jsarrett/StackedCharger/6s_750mA/6s_750mA.kicad_pcb

## KiCad design 6s_750mA/6s_750mA.kicad_pcb (2024-08-13)

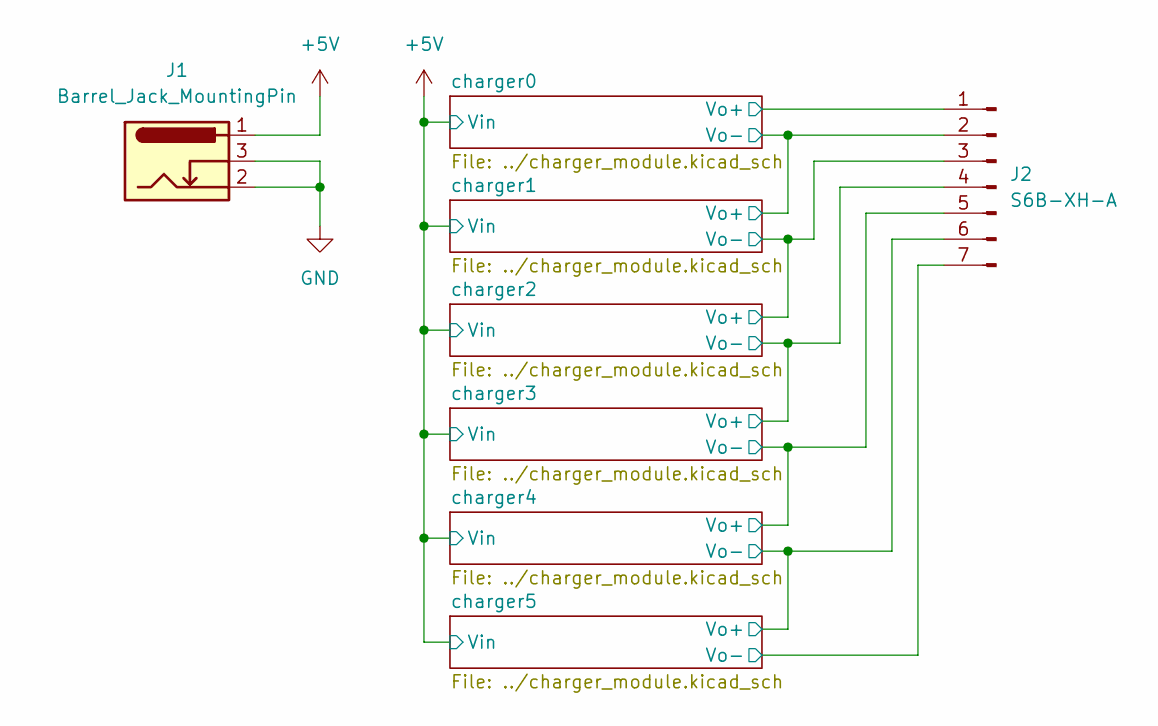
[picture p1: schematic 6s_750mA.kicad_sch]

Parts:
J1: Barrel_Jack_MountingPin; BarrelJack_CUI_PJ-102AH_Horizontal; Manufacturer Part Number PJ-102AH
J2: S6B-XH-A; JST_XH_S7B-XH-A_1x07_P2.50mm_Horizontal; Manufacturer Part Number S7B-XH-A

Connections:
+5V: J1.1; also elsewhere on the board
/charger0/Vo+: J2.1; also elsewhere on the board
/charger0/Vo-: J2.2; also elsewhere on the board
/charger1/Vo-: J2.3; also elsewhere on the board
/charger2/Vo-: J2.4; also elsewhere on the board
/charger3/Vo-: J2.5; also elsewhere on the board
/charger4/Vo-: J2.6; also elsewhere on the board
/charger5/Vo-: J2.7; also elsewhere on the board
GND: J1.2, J1.3; also elsewhere on the board

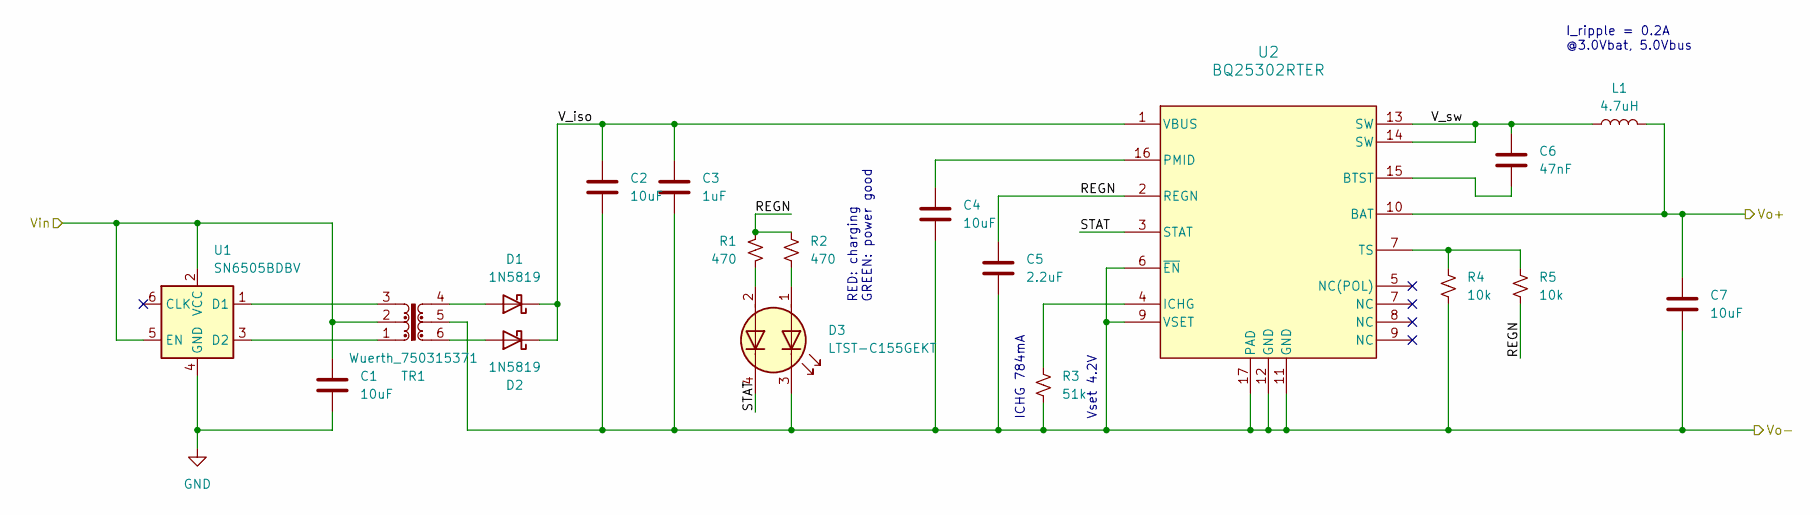
[picture p2: schematic charger_module.kicad_sch]

Parts:
C1, C2: 10uF; C_0805_2012Metric; Manufacturer Part Number CL21A106MQFNNNE
C3: 1uF; C_0603_1608Metric; Manufacturer Part Number CC0603KRX7R7BB105
C4, C7: 10uF; C_0603_1608Metric; Manufacturer Part Number CL10A106KQ8NNNL
C5: 2.2uF; C_0603_1608Metric; Manufacturer Part Number CL10A225KQ8NNNC
C6: 47nF; C_0603_1608Metric; Manufacturer Part Number CL10B473KO8NNNC
D1, D2: 1N5819; D_SOD-123F; Manufacturer Part Number 1N5819W
D3: LTST-C155GEKT; LED_RGB_Wuerth-PLCC4_3.2x2.8mm_150141M173100; Manufacturer Part Number LTST-C155GEKT
L1: 4.7uH; L_0805_2012Metric_Pad1.15x1.40mm_HandSolder; Manufacturer Part Number WIP201610S-4R7MLDG
R1, R2: 470; R_0603_1608Metric; Manufacturer Part Number RT0603FRE07470RL
R3: 51k; R_0603_1608Metric; Manufacturer Part Number RT0603FRE0751KL
R4, R5: 10k; R_0603_1608Metric; Manufacturer Part Number RT0603FRE0710KL
TR1: Wuerth_750315371; Transformer_Wuerth_750315371; Manufacturer Part Number 750315371
U1: SN6505BDBV; SOT-23-6; Manufacturer Part Number SN6505BDBV
U2: BQ25302RTER; RTE0016C; Manufacturer Part Number BQ25302RTER

Connections:
+5V: C1.1, TR1.2, U1.2 (VCC), U1.5 (EN); also elsewhere on the board
/charger0/REGN: C5.1, R1.1, R2.1, R5.2, U2.2 (REGN)
/charger0/STAT: D3.4 (K2), U2.3 (STAT)
/charger0/V_iso: C2.1, C3.1, D1.1 (K), D2.1 (K), U2.1 (VBUS)
/charger0/V_sw: C6.1, L1.1, U2.13 (SW), U2.14 (SW)
/charger0/Vo+: C7.1, L1.2, U2.10 (BAT); also elsewhere on the board
/charger0/Vo-: C2.2, C3.2, C4.2, C5.2, C7.2, D3.3 (K1), R3.2, R4.2, TR1.5, U2.6 (~EN), U2.9 (VSET), U2.11 (GND), U2.12 (GND), U2.17 (PAD); also elsewhere on the board
GND: C1.2, U1.4 (GND); also elsewhere on the board
unnamed: D1.2 (A), TR1.4
unnamed: D2.2 (A), TR1.6
unnamed: D3.1 (A1), R2.2
unnamed: D3.2 (A2), R1.2
unnamed: TR1.3, U1.1 (D1)
unnamed: TR1.1, U1.3 (D2)
unnamed: C6.2, U2.15 (BTST)
unnamed: R3.1, U2.4 (ICHG)
unnamed: C4.1, U2.16 (PMID)
unnamed: R4.1, R5.1, U2.7 (TS)

Parts of its further copies:
C8, C9, C15, C16, C22, C23, C29, C30, C36, C37: 10uF; C_0805_2012Metric; Manufacturer Part Number CL21A106MQFNNNE
C10, C17, C24, C31, C38: 1uF; C_0603_1608Metric; Manufacturer Part Number CC0603KRX7R7BB105
C11, C14, C18, C21, C25, C28, C32, C35, C39, C42: 10uF; C_0603_1608Metric; Manufacturer Part Number CL10A106KQ8NNNL
C12, C19, C26, C33, C40: 2.2uF; C_0603_1608Metric; Manufacturer Part Number CL10A225KQ8NNNC
C13, C20, C27, C34, C41: 47nF; C_0603_1608Metric; Manufacturer Part Number CL10B473KO8NNNC
D4, D5, D7, D8, D10, D11, D13, D14, D16, D17: 1N5819; D_SOD-123F; Manufacturer Part Number 1N5819W
D6, D9, D12, D15, D18: LTST-C155GEKT; LED_RGB_Wuerth-PLCC4_3.2x2.8mm_150141M173100; Manufacturer Part Number LTST-C155GEKT
L2, L3, L4, L5, L6: 4.7uH; L_0805_2012Metric_Pad1.15x1.40mm_HandSolder; Manufacturer Part Number WIP201610S-4R7MLDG
R6, R7, R11, R12, R16, R17, R21, R22, R26, R27: 470; R_0603_1608Metric; Manufacturer Part Number RT0603FRE07470RL
R8, R13, R18, R23, R28: 51k; R_0603_1608Metric; Manufacturer Part Number RT0603FRE0751KL
R9, R10, R14, R15, R19, R20, R24, R25, R29, R30: 10k; R_0603_1608Metric; Manufacturer Part Number RT0603FRE0710KL
TR2, TR3, TR4, TR5, TR6: Wuerth_750315371; Transformer_Wuerth_750315371; Manufacturer Part Number 750315371
U3, U5, U7, U9, U11: SN6505BDBV; SOT-23-6; Manufacturer Part Number SN6505BDBV
U4, U6, U8, U10, U12: BQ25302RTER; RTE0016C; Manufacturer Part Number BQ25302RTER

Connections of its further copies:
+5V: C8.1, C15.1, C22.1, C29.1, C36.1, TR2.2, TR3.2, TR4.2, TR5.2, TR6.2, U3.2 (VCC), U3.5 (EN), U5.2 (VCC), U5.5 (EN), U7.2 (VCC), U7.5 (EN), U9.2 (VCC), U9.5 (EN), U11.2 (VCC), U11.5 (EN); also elsewhere on the board
/charger0/Vo-: C14.1, L2.2, U4.10 (BAT); also elsewhere on the board
/charger1/REGN: C12.1, R6.1, R7.1, R10.2, U4.2 (REGN)
/charger1/STAT: D6.4 (K2), U4.3 (STAT)
/charger1/V_iso: C9.1, C10.1, D4.1 (K), D5.1 (K), U4.1 (VBUS)
/charger1/V_sw: C13.1, L2.1, U4.13 (SW), U4.14 (SW)
/charger1/Vo-: C9.2, C10.2, C11.2, C12.2, C14.2, C21.1, D6.3 (K1), L3.2, R8.2, R9.2, TR2.5, U4.6 (~EN), U4.9 (VSET), U4.11 (GND), U4.12 (GND), U4.17 (PAD), U6.10 (BAT); also elsewhere on the board
/charger2/REGN: C19.1, R11.1, R12.1, R15.2, U6.2 (REGN)
/charger2/STAT: D9.4 (K2), U6.3 (STAT)
/charger2/V_iso: C16.1, C17.1, D7.1 (K), D8.1 (K), U6.1 (VBUS)
/charger2/V_sw: C20.1, L3.1, U6.13 (SW), U6.14 (SW)
/charger2/Vo-: C16.2, C17.2, C18.2, C19.2, C21.2, C28.1, D9.3 (K1), L4.2, R13.2, R14.2, TR3.5, U6.6 (~EN), U6.9 (VSET), U6.11 (GND), U6.12 (GND), U6.17 (PAD), U8.10 (BAT); also elsewhere on the board
/charger3/REGN: C26.1, R16.1, R17.1, R20.2, U8.2 (REGN)
/charger3/STAT: D12.4 (K2), U8.3 (STAT)
/charger3/V_iso: C23.1, C24.1, D10.1 (K), D11.1 (K), U8.1 (VBUS)
/charger3/V_sw: C27.1, L4.1, U8.13 (SW), U8.14 (SW)
/charger3/Vo-: C23.2, C24.2, C25.2, C26.2, C28.2, C35.1, D12.3 (K1), L5.2, R18.2, R19.2, TR4.5, U8.6 (~EN), U8.9 (VSET), U8.11 (GND), U8.12 (GND), U8.17 (PAD), U10.10 (BAT); also elsewhere on the board
/charger4/REGN: C33.1, R21.1, R22.1, R25.2, U10.2 (REGN)
/charger4/STAT: D15.4 (K2), U10.3 (STAT)
/charger4/V_iso: C30.1, C31.1, D13.1 (K), D14.1 (K), U10.1 (VBUS)
/charger4/V_sw: C34.1, L5.1, U10.13 (SW), U10.14 (SW)
/charger4/Vo-: C30.2, C31.2, C32.2, C33.2, C35.2, C42.1, D15.3 (K1), L6.2, R23.2, R24.2, TR5.5, U10.6 (~EN), U10.9 (VSET), U10.11 (GND), U10.12 (GND), U10.17 (PAD), U12.10 (BAT); also elsewhere on the board
/charger5/REGN: C40.1, R26.1, R27.1, R30.2, U12.2 (REGN)
/charger5/STAT: D18.4 (K2), U12.3 (STAT)
/charger5/V_iso: C37.1, C38.1, D16.1 (K), D17.1 (K), U12.1 (VBUS)
/charger5/V_sw: C41.1, L6.1, U12.13 (SW), U12.14 (SW)
/charger5/Vo-: C37.2, C38.2, C39.2, C40.2, C42.2, D18.3 (K1), R28.2, R29.2, TR6.5, U12.6 (~EN), U12.9 (VSET), U12.11 (GND), U12.12 (GND), U12.17 (PAD); also elsewhere on the board
GND: C8.2, C15.2, C22.2, C29.2, C36.2, U3.4 (GND), U5.4 (GND), U7.4 (GND), U9.4 (GND), U11.4 (GND); also elsewhere on the board
unnamed: D4.2 (A), TR2.4
unnamed: D5.2 (A), TR2.6
unnamed: D6.1 (A1), R7.2
unnamed: D6.2 (A2), R6.2
unnamed: D7.2 (A), TR3.4
unnamed: D8.2 (A), TR3.6
unnamed: D9.1 (A1), R12.2
unnamed: D9.2 (A2), R11.2
unnamed: D10.2 (A), TR4.4
unnamed: D11.2 (A), TR4.6
unnamed: D12.1 (A1), R17.2
unnamed: D12.2 (A2), R16.2
unnamed: D13.2 (A), TR5.4
unnamed: D14.2 (A), TR5.6
unnamed: D15.1 (A1), R22.2
unnamed: D15.2 (A2), R21.2
unnamed: D16.2 (A), TR6.4
unnamed: D17.2 (A), TR6.6
unnamed: D18.1 (A1), R27.2
unnamed: D18.2 (A2), R26.2
unnamed: TR2.3, U3.1 (D1)
unnamed: TR2.1, U3.3 (D2)
unnamed: C13.2, U4.15 (BTST)
unnamed: R8.1, U4.4 (ICHG)
unnamed: C11.1, U4.16 (PMID)
unnamed: R9.1, R10.1, U4.7 (TS)
unnamed: TR3.3, U5.1 (D1)
unnamed: TR3.1, U5.3 (D2)
unnamed: C20.2, U6.15 (BTST)
unnamed: R13.1, U6.4 (ICHG)
unnamed: C18.1, U6.16 (PMID)
unnamed: R14.1, R15.1, U6.7 (TS)
unnamed: TR4.3, U7.1 (D1)
unnamed: TR4.1, U7.3 (D2)
unnamed: C27.2, U8.15 (BTST)
unnamed: R18.1, U8.4 (ICHG)
unnamed: C25.1, U8.16 (PMID)
unnamed: R19.1, R20.1, U8.7 (TS)
unnamed: TR5.3, U9.1 (D1)
unnamed: TR5.1, U9.3 (D2)
unnamed: C34.2, U10.15 (BTST)
unnamed: R23.1, U10.4 (ICHG)
unnamed: C32.1, U10.16 (PMID)
unnamed: R24.1, R25.1, U10.7 (TS)
unnamed: TR6.3, U11.1 (D1)
unnamed: TR6.1, U11.3 (D2)
unnamed: C41.2, U12.15 (BTST)
unnamed: R28.1, U12.4 (ICHG)
unnamed: C39.1, U12.16 (PMID)
unnamed: R29.1, R30.1, U12.7 (TS)

Notes on the sheet:
I_ripple = 0.2A @3.0Vbat, 5.0Vbus
ICHG 784mA
RED: charging GREEN: power good
Vset 4.2V

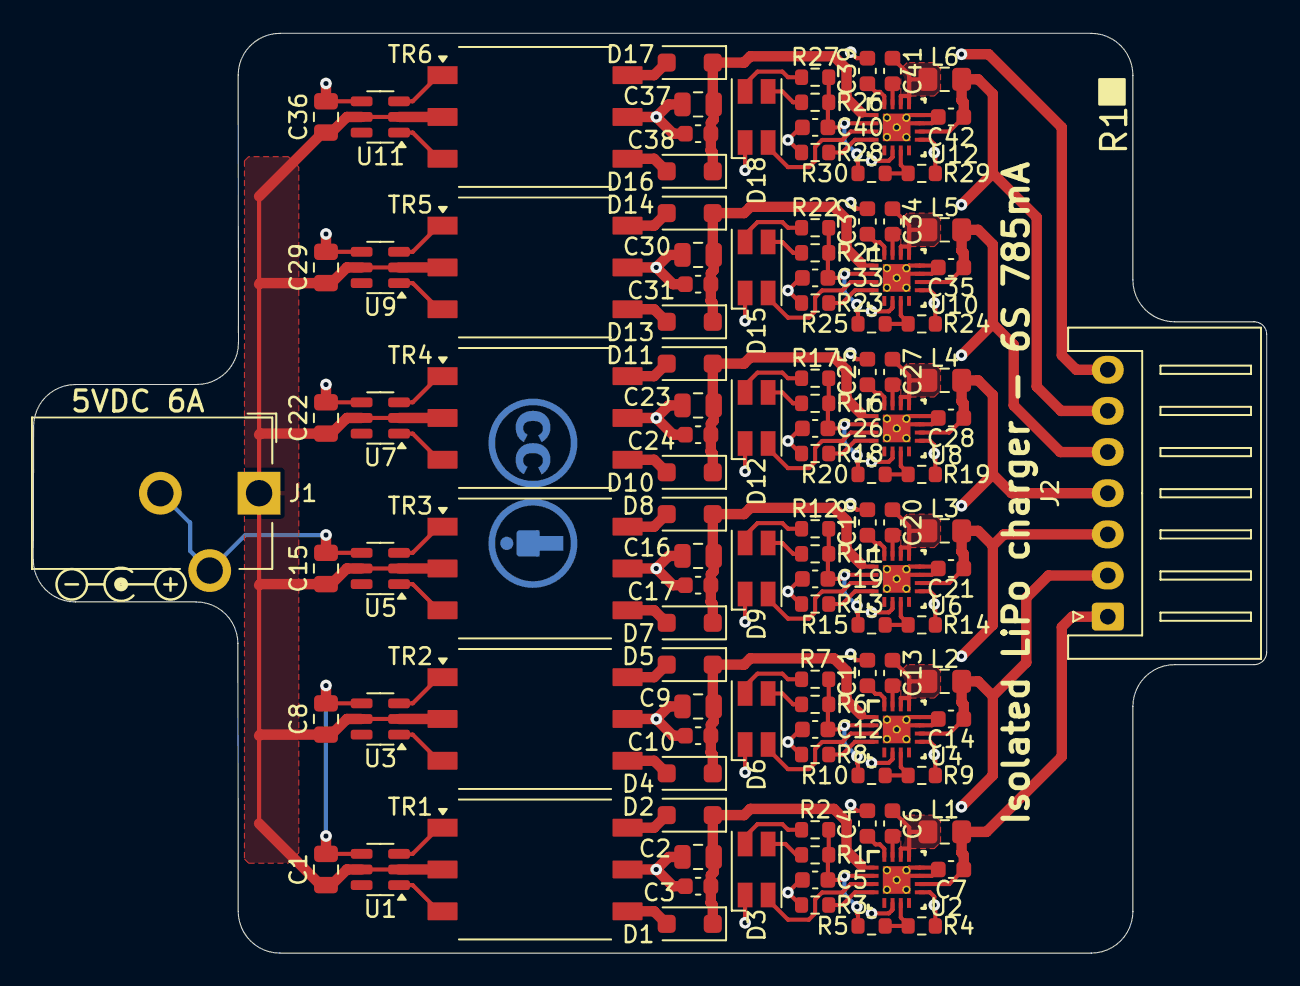
[picture p3: board 6s_750mA.kicad_pcb from above]

Board: 2 copper layers, 74.9 x 55.9 mm, 116 parts (0 on the bottom side), 93 nets.
