jsarrett/StackedCharger/(commit log)

2024-07-23 isolated charger module schematic
    [charger_module.kicad_sch]
2024-07-23 6s charger schematic
    [6s_750mA.kicad_sch]
2024-07-23 initial layout
    [6s_750mA.kicad_pcb]
2024-07-23 add logos and CC icons to bottom
    [6s_750mA.kicad_pcb]
2024-07-23 extend ground pour and use thermal reliefs for easier soldering
    [6s_750mA.kicad_pcb]
2024-07-23 fix 3d model for charge controller
    [6s_750mA.kicad_pcb]
2024-07-24 6s R0 DFM checked
    [6s_750mA.kicad_pcb]
2024-07-24 6s R0 out to fab
    [6s_750mA-B_Cu.gbl, 6s_750mA-B_Mask.gbs, 6s_750mA-B_Paste.gbp, 6s_750mA-B_Silkscreen.gbo, 6s_750mA-Edge_Cuts.gm1, 6s_750mA-F_Cu.gtl, 6s_750mA-F_Mask.gts, 6s_750mA-F_Paste.gtp]
2024-08-01 fix color assignment on status LEDs
    [charger_module.kicad_sch]
2024-08-01 fix supplier part numbers for power connector and battery connector
    [6s_750mA.kicad_sch]
2024-08-01 update PCB with correct LED colors, and fix typo
    [6s_750mA.kicad_pcb]
2024-08-13 switch to BQ25302 charger IC instead of LDO
    [charger_module.kicad_sch]
2024-08-13 new layout using switching regulator
    [6s_750mA.kicad_pcb]
2024-08-13 production files for 6s_750mA R1
    [6s_750mA-B_Cu.gbl, 6s_750mA-B_Mask.gbs, 6s_750mA-B_Paste.gbp, 6s_750mA-B_Silkscreen.gbo, 6s_750mA-Edge_Cuts.gm1, 6s_750mA-F_Cu.gtl, 6s_750mA-F_Mask.gts, 6s_750mA-F_Paste.gtp]
