jsarrett/StackedCharger/(notices)

Notices in the files:
6s_750mA/6s_750mA.kicad_pcb:
©2024 by James Sarrett
licensed under CC BY 4.0
